kpayinda/PIM_V01/PIM_V01/PIM_V01_DesignRecord.docx

# PIM_V01 PCBA Design Record

Payload Interface Module

Not for flight

Author: Kala Payinda

RAW PCB: PIM_V01_GERBERS

Ordered 13-AUG-26

https://github.com/kpayinda/PIM/commit/edd9c8c313321c0a0980f22faca5c752f7d752eb

Revision Date: 13-AUG-26

## Contents

## Overview

The Payload Interface Module (PIM) is a custom 4-layer PCB that interfaces a 12 V small-satellite bus with customer payloads and onboard processing hardware. The design targets a ~5 krad (Si) total-ionising-dose lifetime with no formal certification requirement, and prioritises low power consumption and fully hand-solderable components.

Core hardware: STM32H7A3VIT6 MCU (LQFP-100), dual FDCAN, USB-C customer interface, TPS62933 point-of-load bucks, TPS55288 programmable payload rail, and a three-tier NOR/FRAM/NAND memory stack. The iCE40 FPGA and its 1V2 core rail are deferred beyond the MVP and are out of scope for this record.

This record captures final design solutions only, with the governing calculation and a short rationale for each. Sections are grouped into flight hardware (populated on the orbital build) and non-flight hardware (ground-support and debug features, DNP for flight).

## 1.0 Flight Design Sections

### 1.1 Input Power

Function: Accept the +12 V satellite bus, protect against reverse polarity and transients, filter switching noise, and split into a housekeeping branch and a fault-isolated payload branch.

Final solution:

- Reverse-polarity protection: high-side P-channel MOSFET Vishay SQJ407EP (blocks reverse current with low conduction loss vs. a series diode).
- Transient protection: SMBJ12A TVS across the input. Chosen over SMBJ16A because its ~19.9 V clamp stays below the downstream eFuse 20 V absolute maximum.
- Input filter: bulk input capacitance plus a C-L-C pi filter on the 12 V rail to stop buck switching noise back-propagating onto the satellite bus.
- Housekeeping branch: feeds the 3V3 and 1V2 bucks directly, bypassing the eFuse, so a payload fault cannot disable the module's own supplies.
- Payload branch: TI TPS259541DSGR eFuse for the payload supply, current limit ≈ 4 A.

eFuse current-limit set: R_ILIM ≈ 511 Ω sets the ~4 A limit per the TPS259541 I_LIM(A) = K_ILIM / R_ILIM relationship.

Rationale: The eFuse sits only on the payload branch — a payload short is current-limited and isolated, while housekeeping remains alive. A dedicated housekeeping eFuse was rejected because a housekeeping fault renders the module useless regardless, and module-level disconnection is handled by the satellite bus.

### 1.2 USB-C Interface

Function: Customer-facing interface for firmware update (DFU) and the digital-twin link. USB Full Speed (12 Mbps), which far exceeds any CubeSat UHF downlink rate — no external ULPI PHY required.

Final solution:

- Connector: GCT 12402143E512A USB-C receptacle.
- CC configuration: 2 × 5.1 kΩ pulldowns on CC1/CC2 (upstream-facing device / sink).
- ESD protection: ST USBLC6-2SC6 on the D+/D− pair.
- Power path: discrete cross-coupled P-FET power selector between USB-VBUS and the bus-derived rail (chosen over the TPS2116 for hand-solderability and part control).
- Local 3V3: AP2112K-3.3 LDO (SOT-23-5) generates 3.3 V from the 5 V USB VBUS for bench operation.
- USB data lines: PA11 (D−) / PA12 (D+) on the STM32H7A3.

DFU bootloader: BOOT0 sampled high at NRST release enters the STM32 ROM bootloader. USB clocking uses the internal HSI48 oscillator with the Clock Recovery System (CRS) locked to USB SOF — no external crystal needed.

Note on pin allocation: because FDCAN1 defaults to PA11/PA12 and would collide with USB, the CAN peripherals are remapped (see §1.5).

### 1.3 Power Regulation (Point-of-Load Bucks)

Function: Generate the +5 V, +3V3 and +1V2 rails from the +12 V bus. A single synchronous buck controller family (TI TPS62933) is used throughout to minimise the BOM and share layout patterns.

Output-voltage setting: Each rail is set by the feedback divider, with R_FBB = 10 kΩ (1 %) on all rails:

V_OUT = 0.8 V × (1 + R_FBT / 10 kΩ)

Rail | R_FBT (1%) | Calculated V_OUT | Purpose
+5V | 52.3 kΩ | 4.98 V | Payload supply
+3V3 | 31.6 kΩ | 3.33 V | MCU VDD, sensors, pull-ups
+1V2 | 4.99 kΩ | 1.20 V | FPGA core (deferred, DNP for MVP)

Inductor selection: Sized for the rail's full 3 A capability (not the present load), targeting ripple ratio K = ΔI_L/I_OUT ≈ 0.3:

L = V_OUT × (V_IN − V_OUT) / (V_IN × f_sw × 0.3 × I_OUT,max)

At V_IN = 12 V, f_sw = 500 kHz, I_OUT,max = 3 A: the 5 V rail needs 6.5 µH and the 3V3 rail 5.3 µH, so a single 6.8 µH part covers both. Selected: Würth WE-LHMI 6.8 µH (shielded). With 6.8 µH the 5 V rail ripple is ≈ 0.86 A (29 %), peak inductor current ≈ 3.4 A; the 3V3 rail ripple is ≈ 0.7 A (23 %).

- Saturation current: I_sat ≥ ~5 A, above the ~3.4 A peak and the IC's high-side current limit, so the core does not saturate before the IC protects.
- RMS / DCR: RMS rating ≥ 3 A, low DCR (~20–50 mΩ) for efficiency.
- Output caps: 2 × 22 µF per rail.
- Switching frequency: RT pin floated for the default 500 kHz (~400–500 kHz keeps harmonics below the UHF band).

### 1.4 Programmable Payload Rail

Function: A firmware-controlled, adjustable supply for the customer payload, able to source above and below 12 V.

Final solution:

- IC: TI TPS55288 buck-boost converter with I²C voltage/current control.
- Hardware voltage ceiling: set by R_top = 115 kΩ, R_bot = 10 kΩ to cap the output regardless of firmware.
- Current sense: 10 mΩ resistor for the internal current loop / telemetry.
- Enable: EN held low at boot; firmware programs the target voltage over I²C before enabling the rail.

Ceiling calculation: With the 1.2 V internal reference: V_OUT(max) = 1.2 V × (1 + 115 kΩ / 10 kΩ) = 15.0 V.

Rationale: The hardware ceiling bounds the worst case even under a firmware fault, and the EN-low-until-configured sequence prevents an undefined voltage from reaching the payload at power-up.

### 1.5 Dual CAN Interface

Function: Redundant command/telemetry link to the host interface adapter via two independent FDCAN buses with firmware failover.

Final solution:

- Transceivers: Microchip MCP2562FDT-E/SN, one per bus.
- Pin allocation: FDCAN1 on PD0/PD1 and FDCAN2 on PB12/PB13 — FDCAN1 moved off its PA11/PA12 default to avoid the USB conflict.
- Termination: split termination at the connector, 2 × 60 Ω with a 4.7 nF cap to GND for common-mode filtering.
- Common-mode filtering: common-mode choke per bus (Würth WE-CNSA 784234101).
- Transient protection: DNP TVS footprints at each connector (fit if the harness environment requires).
- Domain de-coupling: ~1 kΩ series resistors on the TXD lines to mitigate the bench-only power-domain asymmetry between +3V3_MCU and +3V3_HK (identical in flight).

Signal list:

Signal | Direction | Description
FDCAN1_TX | MCU → Transceiver | CAN1 transmit
FDCAN1_RX | Transceiver → MCU | CAN1 receive
FDCAN2_TX | MCU → Transceiver | CAN2 transmit
FDCAN2_RX | Transceiver → MCU | CAN2 receive
CAN1_STBY | MCU → Transceiver | Disable CAN1 driver stage
CAN2_STBY | MCU → Transceiver | Disable CAN2 driver stage

Note: common-mode choke dot polarity is a physical-part property not resolvable from a generic KiCad symbol — use the manufacturer symbol, or fit 0 Ω jumpers and validate orientation on a scope.

### 1.6 Microcontroller

Selected part: STMicroelectronics STM32H7A3VIT6 (Cortex-M7, LQFP-100). LQFP package satisfies the hand-solder constraint.

Final solution:

- Core supply: +3V3 (VDD); internal SMPS/LDO as configured.
- Boot: BOOT0 strapping selects the ROM DFU bootloader (see §1.2).
- Peripherals in use: USB FS (PA11/PA12), FDCAN1/2 (§1.5), SPI to the memory stack (§1.7).
- Firmware: SEU-tolerant design — independent + window watchdogs, memory scrubbing, and CRC-protected critical state in FRAM.

### 1.7 Memory Architecture

Function: Three tiers matched to their reliability needs; all on SPI with independent chip-select lines. SD/eMMC cards were rejected for orbit (hidden controllers, power-cycle corruption risk, uncharacterised single-event-latch-up surface).

Tier | Device | Size | Role
Program | STM32H7A3 internal NOR flash | 2 MB | Firmware and DFU image
Critical state | Infineon FM25V20A-G FRAM | 256 KB | Config / state — dual-copy + CRC32
Bulk telemetry | Winbond W25N01GVSFIG NAND | 1 Gbit | Telemetry logging

Rationale: FRAM holds critical state because it has no wear-out and survives unexpected power loss; it is stored as two CRC-protected copies for SEU integrity. NAND sizing (1 Gbit) is pending confirmation of the actual payload instrument data rate.

### 1.8 Passives Selection

Capacitors: AEC-Q200.

## 2.0 Non-Flight Design Sections

The features below support bench bring-up and debug only. All associated components are do-not-populate (DNP) on flight builds.

### 2.1 Indication LEDs

Status/indication LEDs are a ground-support aid and are DNP on flight builds (parasitic current draw and an additional single-event surface serve no orbital purpose).

TO BE COMPLETED — the design history reviewed for this record contains no finalised indication-LED circuit (rail assignments, series-resistor values, or drive method). Populate this section with the final LED count, the rail each is driven from, and the current-limit resistor per LED before publishing.

### 2.2 Test Points

Debug / SWD access: Bare SWD pads only — no populated connector. Exposed pads: SWDIO, SWCLK, GND, VTREF. Programmed with an ST-LINK or Segger J-Link (internal use only; not exposed to the customer).

General principle: all ground-support-only access (SWD pads and any additional rail/signal test points) is DNP or bare-pad on flight builds, consistent with the DNP-for-flight radiation-mitigation framework.

TO BE COMPLETED — beyond the SWD pads above, the reviewed history does not enumerate dedicated rail/signal test points. Add the final test-point list (net, location/reference) before publishing.

## 3.0 Bring-up Plan

20-SEP-26

RANDOM EDITS.

THE NOTES FROM THE SCHEMATIC:

MCU DESIGN NOTES:

- MCU osc caps: load cap ≈ 2 × (CL − C_stray) = 2 × (18 − ~4.5) ≈ 27Pf

FPGA:

- config: MCU as SPI master, FPGA in slave config mode

- runtime:

POWER UP SEQ:

HK rails immediately on

Initialise H7

Enable PL rails

Check PGOOD

Begin PL operation
