kpayinda/PIM_V01/PIM_V01/PIM_V01_BRINGUP.docx

# PIM_V01 Bring Up Plan

Kala Payinda

27-AUG-26

# 1. Equipment

- Bench PSU (current-limit, 0–30 V/≥1 A)
- DMM ×2 · 4-ch scope + low-C probes
- SWD debugger (ST-LINK/J-Link, 1.27 mm) for J7
- USB-C + STM32CubeProgrammer
- CAN analyser/logic analyser

# 2. Component idle-current reference (from datasheets)

Device | Qty | Rail | Idle / quiescent (typ) | Active / notes
Green LED 150060GS75000 | 9 | various | ≈5 mA each when lit | Vf 3.2 V@20 mA; R's sized so every rail ≈3–5 mA/LED — dominant idle load
TPS62933 buck (U6–U10) | 5 | — | Iq 12 µA (SD 2 µA) | reflected loss only; switching adds little at light load
TPS259541 eFuse (U1) | 1 | 12V_HK | Iq 175 µA (250 max) | +inrush during +12V_PL soft-start
MP28167 VARI (U12) | 1 | 12V_PL | Iq 1 mA (SD 3 µA) | no-load switching a few mA; load = payload
MCP2562FD CAN (U4,U5) | 2 | 5V_HK | 5 mA each recessive | 45 mA each dominant (TX); standby 5 µA
AP2112K LDO (U11) | 1 | 5V_USB | Iq ≈55 µA | USB path only — 0 when on 12 V alone
MT29F1G01 NAND (U13) | 1 | 3V3_MCU | standby ≈0.1 mA | read/prog ≈25 mA (brief)
MB85RS256 FRAM (U14) | 1 | 3V3_MCU | standby ≈µA | read ≈1–2 mA (brief)
USBLC6 ESD (U2) | 1 | — | leakage (nA) | —
STM32H7 MCU (U3) | 1 | 3V3_MCU | run 40–250 mA | clock-dependent — measure; biggest variable

Reflection to 12 V: a lower-rail load costs I₁₂ ≈ P_load /(η·12 V); η≈0.7 at the few-mA LED level, ≈0.85 once a rail carries tens of mA. Buck/eFuse Iq (µA) is negligible.

Part notes: CAN = MCP2562FD (VDD +5V_HK, VIO +3V3_HK, STBY low = always normal). FRAM U14 = MB85RS256. HSE Y1 = 24 MHz. MCU (U3) is not in the supplied BOM — treated as STM32H7 LQFP-100; confirm PN.

# 3. Expected 12 V supply current per stage

Cumulative = board idle at that stage (all indicator LEDs lit, no external payload load). Set the bench limit ~2–3× the cumulative figure.

Stage | Newly-added draw | + @12V | Cumulative @12V (idle) | I-limit | Transients / notes
1A | D14 LED | ~5 mA | ~5 mA | 100 mA | —
1B | eFuse Iq + D15 LED | ~5 mA | ~10 mA | 100 mA | inrush on +12V_PL soft-start
2 | HK bucks + D9,D10 | ~5 mA | ~15 mA | 150 mA | 1V2 rail no LED
3 | 3V3_MCU mux (12 V side) | ~0 | ~15 mA | 150 mA | USB path adds D2 5 mA on USB, not 12 V
4–5 | STM32 run | +15–80 mA | 30–95 mA | 300 mA | flash/DFU; low SYSCLK ≈ low end
6 | NAND+FRAM idle | ~0 | 30–95 mA | 300 mA | NAND read +~10 mA burst
7 | PL rails: D11,D12 + VARI | ~9 mA | 40–105 mA | 400 mA | VARI at V no-load; payload load TBD
8 | 2× CAN recessive | ~5 mA | 45–110 mA | 500 mA | CAN dominant/TX +~40 mA burst
9 | FPGA config lines | ~0 | 45–110 mA | 500 mA | external FPGA powered separately
10 | full board idle | — | 45–110 mA | ≥500 mA | + payload rail load + CAN TX

Range driver = MCU clock: low-speed smoke-test build ≈ low end (~45 mA total); full-speed H7 can push the MCU alone to ~250 mA (~80 mA reflected) → ~110 mA idle. Reading far above these = short or a rail out of regulation, not “just the MCU”.

# 4. Stages

## Stage 0: Bare-board & kit

Side: Both (no parts)

Goal: Confirm PCB + kit before soldering.

Populate

— (inspection only)

Checks / probes

- Every power net open to GND on bare board: +12V_IN, +12V_HK/PL, +5V/+3V3/+1V2_HK, +3V3_MCU, +5V/+3V3/+VARI_PL → OL.
- GND continuity across board (J1 ↔ J10 / mounting holes) < 1 Ω.
- Kit vs BOM: values, polarity marks, thermal-pad parts present; note each part's side from assembly drawing.

Expected @12 V: 0 mA (unpowered).

Gate: Bare board passes visual, all rails open to GND, kit complete.

## Stage 1A: Input protection → +12V_HK

Side: Top

Goal: Reverse-polarity protection + clean 12 V housekeeping.

Populate

J1, Q1 (SQJ407EP), D1 (SMBJ12A), D4 (BZT52C15), R8 100k, C4/C5 47µF, C6 10µF, D14+R79 (LED).

Checks / probes

- Verify J1 polarity first. PSU 12.0 V, limit 100 mA.
- +12V_HK = 11.9–12.0 V; drop across Q1 < 50 mV; D14 lit.
- Reverse test: apply reversed → ~0 mA, +12V_HK ~0 V (Q1 blocks); restore polarity.

Expected @12 V: ~5 mA (D14 only). >20 mA = short (bridge under Q1, or C4/C5 reversed).

Gate: +12V_HK ~12 V, low stable current, D14 lit.

## Stage 1B: eFuse → +12V_PL

Side: Top

Goal: Fused payload bus with soft-start + UVLO.

Populate

U1 (TPS259541), C1 1µF, C2 0.1µF, R2 866k, R3 150k, C3 3.3nF, R5 511R, R7 10k, D3 (PMEG4010), C8 1µF, D15+R80 (LED).

Checks / probes

- +12V_PL ≈ 12 V; scope shows smooth soft-start ramp (no step).
- Raise +12V_IN slowly → PL turns on ~8.1 V (UVLO, R2/R3).
- Don't judge FLT_N here — its pull-up R7 goes to +3V3_HK (not up until Stage 2).

Expected @12 V: ~10 mA cumulative (adds eFuse Iq 0.18 mA + D15 ~5 mA).

Gate: +12V_PL ~12 V, clean soft-start, UVLO ~8.1 V, no latched fault.

## Stage 2: Housekeeping rails 5/3.3/1.2 V

Side: Bottom

Goal: Always-on rails. Fit + test one buck at a time.

Populate

Per rail: U6+L1(+caps,R45,C37,R25/R26,D9/R31)=5V_HK; U7+L2(R27/R28,D10/R32)=3V3_HK; U8+L3(R29/R30)=1V2_HK.

Checks / probes

- +5V_HK 4.85–5.15 V (D9 lit); +3V3_HK 3.20–3.40 V (D10 lit); +1V2_HK 1.16–1.24 V (no LED, probe C48).
- SW node switching clean; ripple <~1% pk-pk; EN pin ≈ VIN (auto-on via 470k).
- Now +3V3_HK is up → re-check eFuse FLT_N = high (no fault).
- ICs/inductors warm not hot after ~2 min.

Expected @12 V: ~15 mA cumulative (D9,D10 reflected ~5 mA; buck Iq negligible).

Gate: All three HK rails in tol, ripple/thermals OK, eFuse fault healthy.

## Stage 3: USB path & +3V3_MCU mux

Side: Top

Goal: MCU rail from USB-only, bus-only, and both, no contention.

Populate

J4, R1/R4 5.1k (CC), C7/CB2, U2 (USBLC6), C78, U11 (AP2112K), C79, D2+R6, Q2/Q3 (FDN304P), Q4 (DMG2302), R10/R11/R12, R68/R69, C9 10µF.

Checks / probes

- USB-only (bus off): +5V_USB ~5 V (D2 lit), +3V3_USB ~3.3 V, +3V3_MCU ~3.3 V; +12V_HK/+3V3_HK ~0 (no back-feed).
- Bus-only (USB out): +3V3_MCU ~3.3 V via HK path; +5V_USB ~0.
- Both: +3V3_MCU stable, no elevated contention current; CC pull-downs = 5.1k.

Expected @12 V: On 12 V: ~15 mA (mux adds ~0, no MCU yet). On USB: ~5 mA (D2) + LDO 55 µA.

Gate: +3V3_MCU = 3.3 V cleanly from either/both sources, no back-feed.

## Stage 4: MCU core & debug

Side: Top

Goal: STM32 alive; SWD + USB-DFU proven. Power from USB only.

Populate

U3, C89–C95 (decoupling), C99/C98 (VDDA/VREF), C96/C97 2.2µF (VCAP), Y1 24MHz + C64/C100 27pF, SW1+C63, J8+R13 10k (BOOT0), J7 (SWD).

Caution: First light from USB only. If using the bench 12 V instead, limit to ~150 mA (MCU + HK is well under that).

Checks / probes

- +3V3_MCU at MCU (C95) 3.2–3.4 V; VCAP (C96) ~1.2 V (core LDO alive); VDDA/VREF 3.3 V.
- nRST idle ~3.3 V, SW1 → 0 V; BOOT0 low with J8 open.
- SWD reads correct STM32H7 IDCODE; HSE (24 MHz) oscillates after FW enable (check via MCO).
- J8 jumpered (BOOT0 high) + USB → enumerates as ‘STM32 BOOTLOADER’ (DFU).

Expected @12 V: USB-powered here. If run from 12 V: adds ~15–80 mA reflected (SYSCLK-dependent) → ~30–95 mA.

Gate: SWD reads correct IDCODE, VCAP ~1.2 V, DFU enumerates.

## Stage 5: FW smoke test & GPIO

Side: — (opt: D5/D6+R81/R82)

Goal: Clock tree, GPIO, enables, source-sense.

Populate

Optional: D5,D6 + R81/R82 100R (TEST LEDs on PB8/PB9).

Checks / probes

- TEST LEDs blink; MCO shows expected SYSCLK; enable GPIOs PE0/PE1/PE2 toggle (no rail effect yet).
- R68/R69 sense reads bus-vs-USB source correctly.

Expected @12 V: As Stage 4; +~5 mA reflected per TEST LED when lit.

Gate: FW runs, clocks correct, enables + source-sense behave.

## Stage 6: NAND + FRAM

Side: Top

Goal: Prove OCTOSPI NAND + SPI4 FRAM.

Populate

U13 (MT29F1G01) + C80/C81, R59 10k (nCS), R60/R61 10k (WP#/HOLD#); U14 (MB85RS256) + decoupling.

Checks / probes

- NAND read-ID = Micron MT29F1G01 (0x2C…); erase/program/read a block, verify.
- FRAM read-ID = expected signature; write pattern, read back (no erase).
- nCS idle high; SCK/IO edges clean.

Expected @12 V: Idle unchanged (standby ~0.1 mA NAND, µA FRAM). Read bursts +~10 mA reflected.

Gate: Both memories return correct IDs and pass write/verify (mark U14 N/A if not stuffed).

## Stage 7: Payload rails 5/3.3/VARI

## CHARACTERISATION W LOAD (SAG)

Side: Bottom

Goal: MCU-switched PL rails, payload isolated.

Populate

One at a time: U9+L4(R37/R38,D11/R33)=5V_PL; U10+L5(R39/R40,D12/R34)=3V3_PL; U12+L6(R53/R54/R56,caps)=VARI. Preconditions: +12V_PL up, MCU running, enables LOW, J11/J12 OPEN.

Caution: VARI reaches 16.8 V but the VARI output caps on this build are rated only 10 V (schematic note). Do NOT command >10 V until the fitted caps are confirmed rated for it, they will be destroyed. Keep the dev setpoint under the cap rating.

Checks / probes

- +5V_EN low → +5V_PL 0 V; drive PE1 high → 4.85–5.15 V (D11). PE0 → +3V3_PL 3.2–3.4 V (D12).
- VARI: I²C scan ACKs 0x60; enable + program a LOW setpoint first, verify, then target.
- MP28167 seq (per note): VREF_L(0x00)=0x05, VREF_H(0x01)=0xEF, GO(0x02)=0x01→16.8 V; IOUT_LIM(0x03)=0x32→2.5 A; CTL1(0x04)=0xB0. Verify vs datasheet map.

Expected @12 V: +~9 mA cumulative (D11+D12 ~5 mA, VARI no-load ~4 mA) → 40–105 mA. VARI load = payload.

Gate: 5V_PL/3V3_PL enable on command in tol; VARI ACKs + holds a safe setpoint. Leave J11/J12 open.

## Stage 8: CAN & payload comms

Side: Top

Goal: Both CAN channels + payload SPI2/USART3/I²C2.

Populate

U4,U5 (MCP2562FD), FL1/FL2 (CMC), R18–R21 60.4R term, R43/R44 1k, D7/D8 (ESD), J5/J6.

Checks / probes

- CAN VDD=+5V_HK, VIO=+3V3_HK; recessive idle CANH≈CANL≈2.5 V; dominant diff ~2 V (TP5–TP8).
- CAN0 loopback: TP1(TX)/TP2(RX) toggle; then external frame on J5 (60.4R term) → TX/RX + ACK. Repeat CAN1 (J6, TP3/4).
- Payload: SPI2 SCK/MOSI/nCS clocked data; USART3 TX baud correct; I²C2 scan/ACK.

Expected @12 V: +~5 mA idle (2× 5 mA recessive reflected). Dominant/TX bursts +~40 mA — expect current jumps during traffic.

Gate: Both CAN channels TX/RX an ACK'd frame; payload buses signal correctly.

## Stage 9: FPGA config (SPI1)

Side: Top

Goal: MCU drives iCE40-style config on J9.

Populate

R62–R65 33R (series), R66/R67 10k (pull-ups), J9.

Checks / probes

- Idle: nCRESET/nSS/CDONE/FPGA_INT high (pull-ups); 33R series present.
- LA on J9: valid reset→clock→bitstream sequence; with FPGA attached, CDONE asserts high on success.

Expected @12 V: ~0 added on-board (pull-ups µA). External FPGA powered separately — not in this budget.

Gate: Clean, correctly-sequenced config waveform; CDONE asserts (if FPGA present).

## Stage 10: Full integration & sequence

Side: Both

Goal: Whole board in intended order, end-to-end.

Populate

Remaining: R83–R86/C105–C108 (chassis RC) + any final parts.

Checks / probes

- Sequence (scope multi-ch): +12V_IN → HK rails auto → +12V_PL (eFuse) → MCU enables +3V3_PL/+5V_PL/+VARI in order → program VARI → payload op.
- eFuse fault path: force overcurrent → PL_FLT to MCU trips. Brown-out: ramp 12 V down → graceful UVLO.
- Fit J11/J12 only after payload load verified. Thermal soak 15 min.

Expected @12 V: 45–110 mA idle (per §3) + payload rail load + CAN-TX bursts. Log full-load draw at +12V_IN.

Gate: Board follows designed sequence, subsystems work under integrated power, faults behave, thermals stable.

# 5. Sign-off Template

Stage | Description | Meas. 12 V (mA) | Date | P/F
0 | Bare board & kit
1A | Input prot → 12V_HK
1B | eFuse → 12V_PL
2 | HK rails
3 | USB & 3V3_MCU mux
4 | MCU core & debug
5 | FW smoke test
6 | NAND + FRAM
7 | Payload rails
8 | CAN & comms
9 | FPGA config
10 | Integration & sequence

# 6. Population Instances

## 6.1 Population Instance #1

29-AUG-26. Kala Payinda. RL soldering labs

Stage | Date | Power | Notes
0 | 29-AUG | N/A
1A | 29-AUG | 12V,4mA | D4 absent (unpop), not blocking.
1B | 29-AUG | XXX | U1 absent (unpop), BLOCKING. Can’t test _PL.
2 | 29-AUG | 12V,10mA | C38 -> 33nF instead. 52.3kR absent (replaced w 2x||100kR). 4.99kR absent (replaced w 5.1kR). - 3V3 rail: 3.354V - 1V2 rail: 1.263V - 5V rail: 4.856V
3 | 29-AUG | | U2 absent (unpop). Q2 Q3 absent.

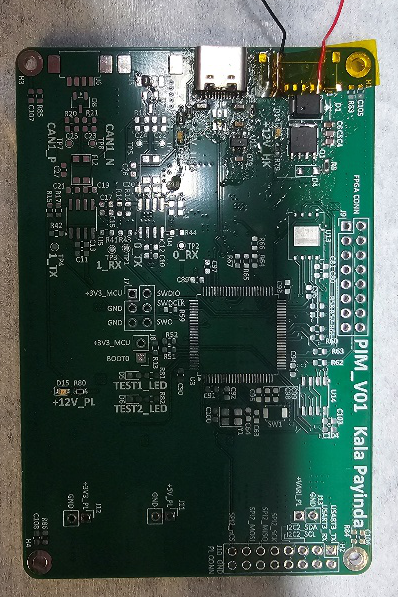
[picture p1: figure]
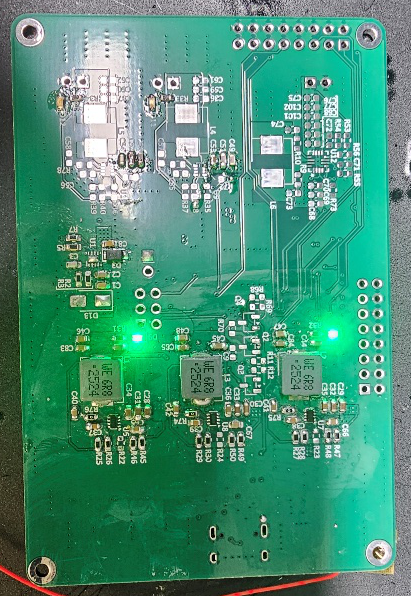
[picture p2: figure]

08-SEP-26. Kala Payinda. Uni

New plan from components not being present for the next week.

1. Test USB-C. Ben provided a USB adaptor that allows a PSU to control power into a USB cable. I will input 5V with hard current limit, and connect it to my PCB now. The LED should come on and the 3V3 LDO should regulate correctly. If this works, then the MCU can be flashed.
2. Populate MCU. Test its ability to be flashed.

Results:

- PSU 5V/2mA: C78: 4.993V, C79: 3.304V
- PSU 5V5/3mA: C78: 5.495, C79: 3.304V
- PSU 4V5/1mA: C78: 4.495V, C79: 3.304V

09-SEP-26. KP. RL

Populated all MCU region.

Results:

- Powered w PSU into power-only USB-C 5V//16mA draw.
- C96 (1V2): 1.009V
- 3V3_MCU: 3.301V
- C98 (VREF+): 3.305V

Obv usb device not showing up on laptop bc dfu cant start w external xtal

10-SEP-26. KP. UNI

Swapping short to have 3v3_mcu just from 12v input. Then try flashing w SWD… still didn’t work.

11-SEP-26. KP. UNI

Only progress was updating stmcubeprog and then its now able to see a target voltage of 3v3. Other note, the ‘missing’ components arrived so now I have all components I need for a fully populated board theoretically.

Usbc: still not working. Tested the D+ and D- continuity, all is fine. My manual shorts are behaving exactly as they should. Tried pulling PA9 (68) high to 5v to see if that allowed it to enter a mode, that didn’t help.

SWD: Tried fixed, added 10k between SWDIO and 3v3, tried putting it in boot0 and not, tried playing w nrst as I pressed connect.

I scoped the IO and CLK pins while they were connected to the pcb, and saw perfect signals as I would expect. The clk was a normal looking square wave that was just one section of it. The IO was a normal 3v3 then a few sections of multiple pulses dragging the signal to 0.

Next step: something is wrong. I am going to make a MVP just to see if my boards mcu is ever able to enter boot mode or be flashed in any way.

MVP:

Populate:

- U3 and its decoupling: C89–C95 (the VDD 100 nF's + bulk), plus C99/C98 on VDDA/VREF+.
- Both VCAP caps — C96 and C97 (2.2 µF). Non-negotiable; the internal core LDO won't be stable without them and that's likely your current problem.
- nRST: C63, and SW1 or just a pull-up — nRST must idle at 3.3 V.
- BOOT0: R13 (pull-down) so it sits low.
- J7 (SWD) — SWDIO, SWCLK, GND, 3V3.
- A clean 3.3 V into VDD/VDDA and solid GND. You can feed 3.3 V straight from a bench supply onto the VDD rail — you do not need the USB-C path, the LDO, the mux, or any of the power tree. SWD flashing needs nothing but VDD, GND, VCAP caps, nRST high, BOOT0 low, and the four SWD wires.

15-SEP-26. KP. UNI

Louis checked w known good mcu and the STLink we bought from digikey does not work.

IMO flashing through DFU should work. My RL pcb I designed works perfectly ONLY through DFU. I am going to add DFU capability to the MVP board.

USB-DFU MVP populate:

- ~~U3~~ ~~+ all decoupling: C89–C94, C95, and C99/C98 on VDDA/VREF+.~~
- ~~Both VCAP caps~~ ~~C96/C97 (2.2 µF).~~
- ~~nRST~~~~: C63~~ ~~plus a 10 kΩ pull-up to 3V3~~ ~~— you just proved this was missing and pulling the chip into reset. Even for DFU, if nRST is held low the bootloader never runs. This is mandatory now.~~
- ~~BOOT0~~~~: your J8 jumper tied high (BOOT0 → 3V3). Confirm 3.3 V at pin 94.~~
- VBAT (6) → 3V3, VDDA (21) → 3V3, VSSA → GND, all VSS → GND, all VDD → 3V3.
- The USB-C data path: the receptacle, and the D+/D− lines from it to PA12 (pin 71) / PA11 (pin 70). Since you don't have U2, bridge its footprint (1↔6, 3↔4) exactly as before — nothing touching pins 2 (GND) or 5 (VBUS).
- CC pulldowns: R1/R4 (5.1 kΩ) on the USB-C CC lines — without these a Type-C host won't even apply VBUS.
- PA9 (pin 68) wired to VBUS (5 V) — the fix for the no-connect. This is the part your board omits and the reason DFU never enumerated. Put it in from the start.
- Power: you can run the whole thing off the USB-C 5 V through your AP2112 path, or feed 3.3 V from a bench supply onto VDD and just use the USB cable for data + VBUS-sense. Either works; bench 3.3 V removes the LDO/mux as variables.

15

Populated another pcb just with ONLY the usb-c connections. But still nort working. Im going to cut open a usb-c cable and probe all to see if my connection is even good. Then probe EVERYTING, between all possible pins.

17-SEP-26. KP. UNI

MVP MCU resoldered as SWD actually didn’t have continuity. So that’s fixed now.

Testing on MVP

19-SEP-26. KP. RL

Mcu works so continuing checklist now. Have all components

Soldered the whole board. Power selector not selecting usb-c correctly… will debug now.

Power selector circuit is wrong. The PMOSs polarity is the wrong way. I attempted to solder them on an angle so 2 legs were direct at the pads then white-wired the 3rd leg to the correct pad, but this didn’t work (got 0V @ +3V3_MCU, and the +12V LED was dimly on, and I think the +1V2 LED was on. So that clearly wasn’t correct. I think that I might have accidentally shorted something wrong when I added the white wires, not too sure.

For now I just removed the 2x PMOS, and shorted the +3V3_USB to +3V3_MCU, and I managed to flash the basic Test LED firmware through DFU successfully.

The eFuse is also not working rn.

Debug steps:

- Ensure polarity correct
- Measure EN_UVLO (pin 2) to GND. Expect 1V2.
- Confirm IN actually reaches the chip. Probe pins 3 and 4 directly on the IC lead.
- Read FLT_N (pin 6). Should be 3V3 (no fault).

Its working. All good. I think the issue was that my diode was the wrong way lol. Fixed now.

Got claude to write me a basic .elf to enable the 3v3 and 5v PL. this worked, both rails were up!

20-SEP-26. KP. UNI

Tried turning vari on, didn’t work. I added more solder to the pads with an iron (very hard to access, would have been easier with a heat gun), then also changed out the 22uF (which are only rated to 10V) with 10uF (rated to 25V). This allows safe testing of above 10V. We tested up to 9V (the prev SW limit), and it worked perfectly, and was precise.
