kpayinda/PIM_V01/PIM_V01/Outputs/pim_sch.pdf

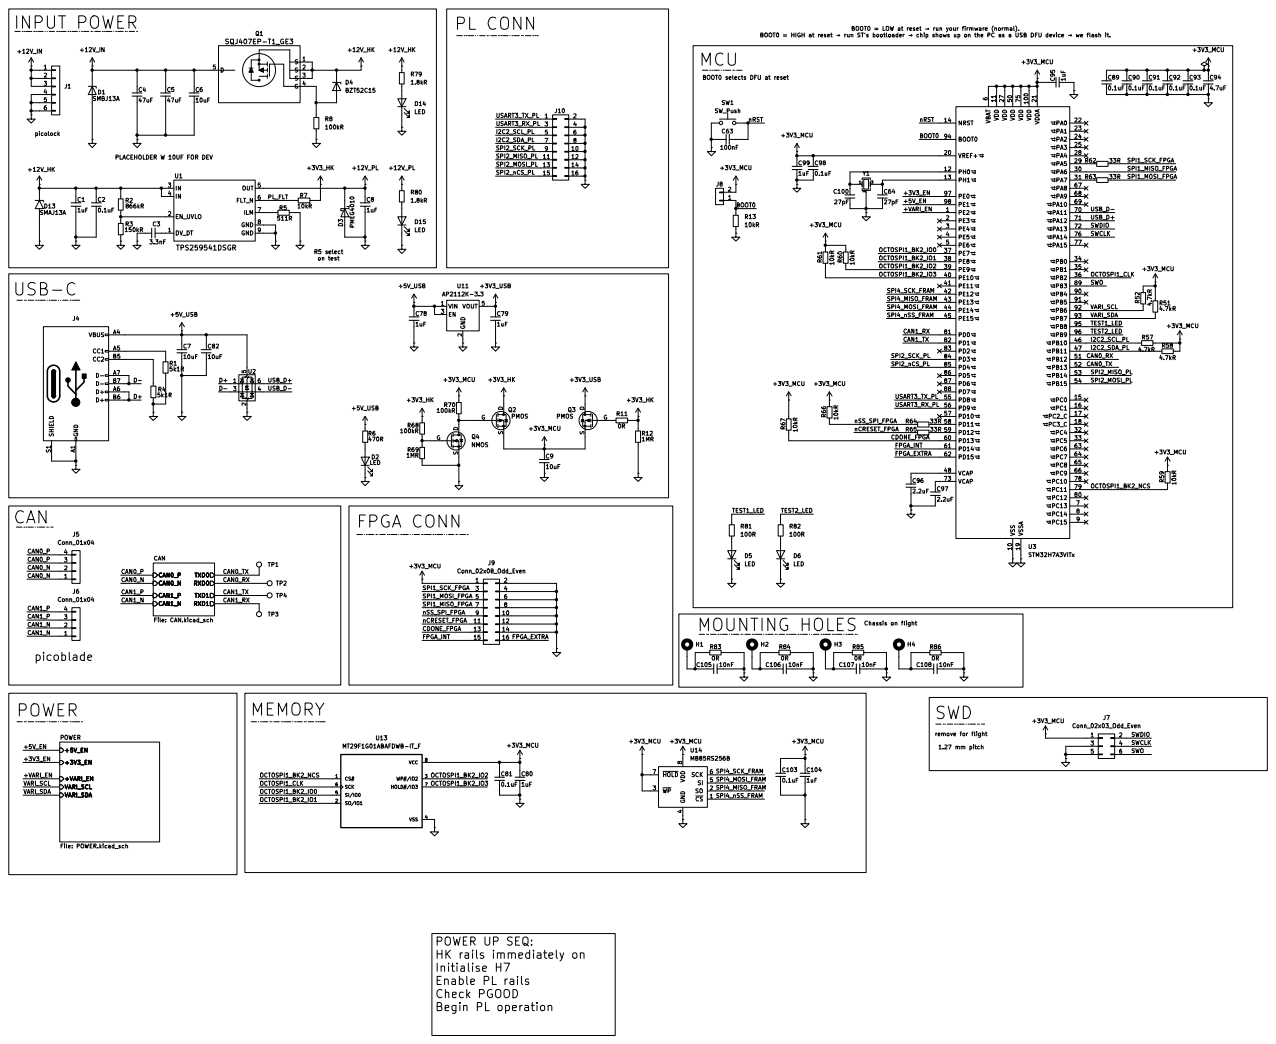
[picture p3: page 1]

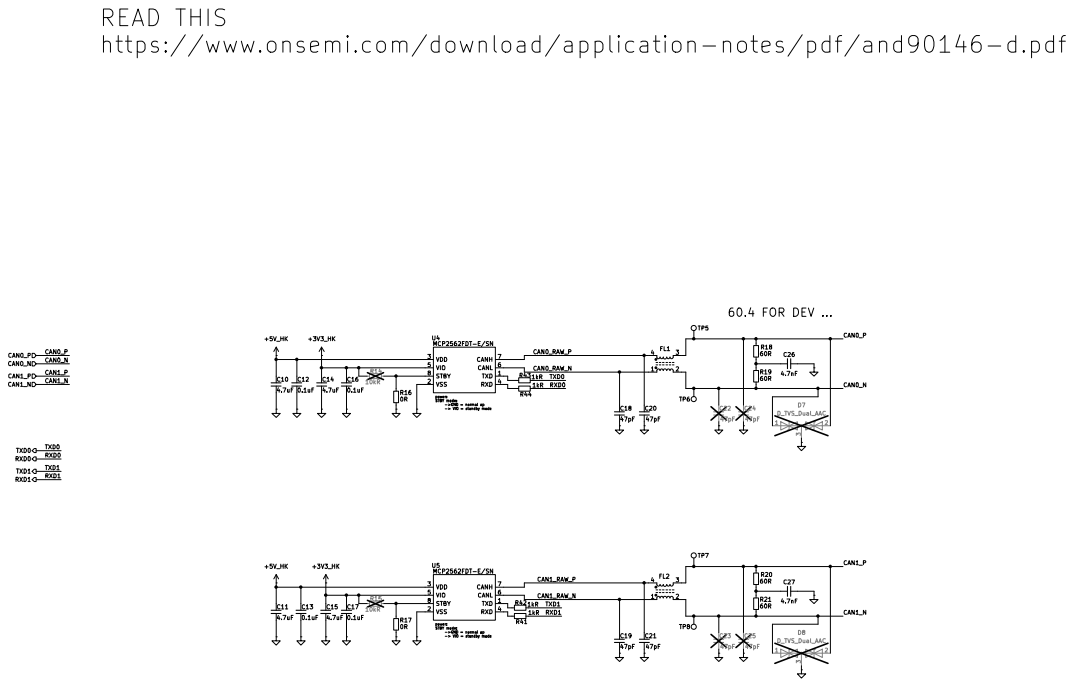
[picture p4: page 2]

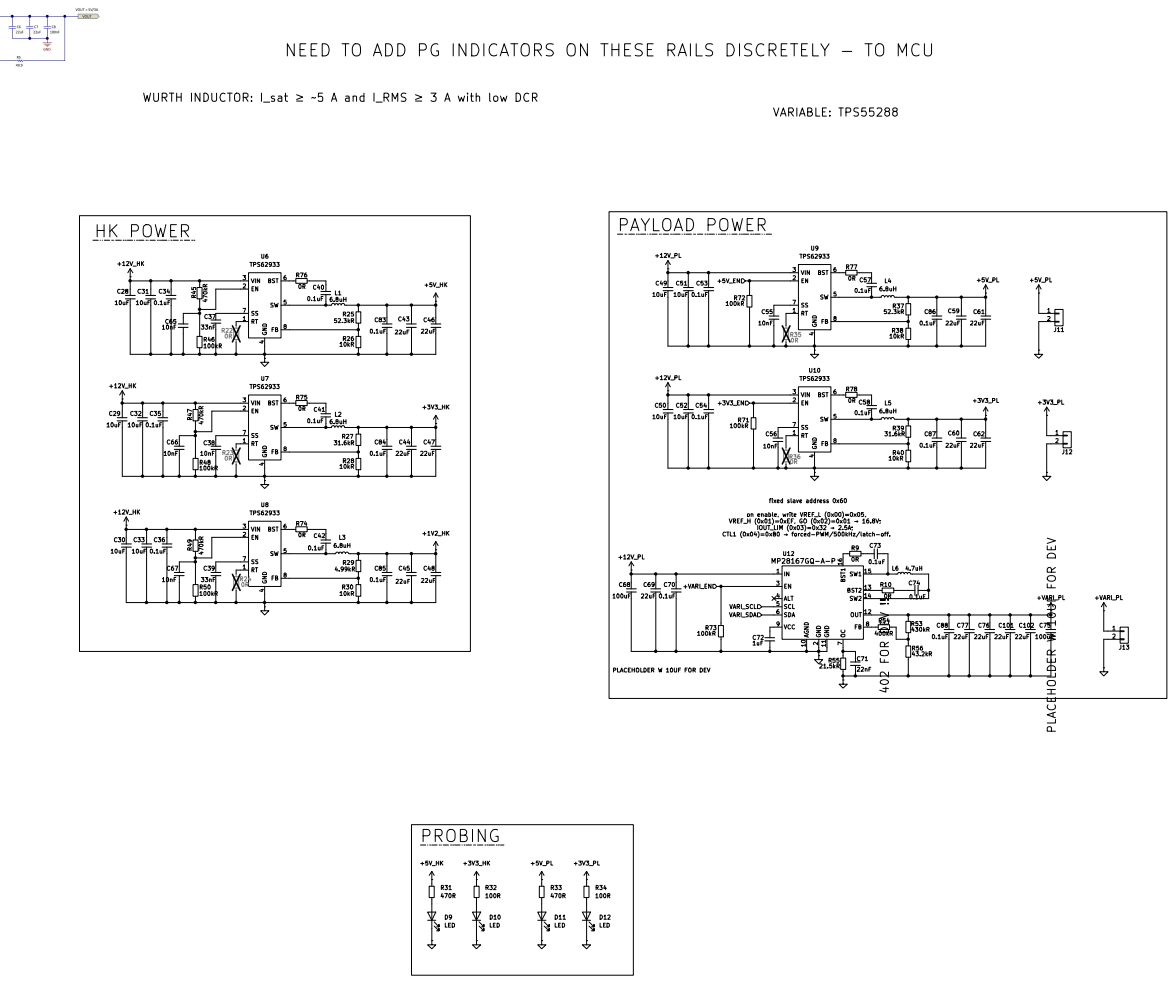
[picture p5: page 3]
