kpayinda/PIM_V01/PIM_V01/PIM_V01.kicad_pcb

## KiCad design PIM_V01/PIM_V01.kicad_pcb (2026-09-21)

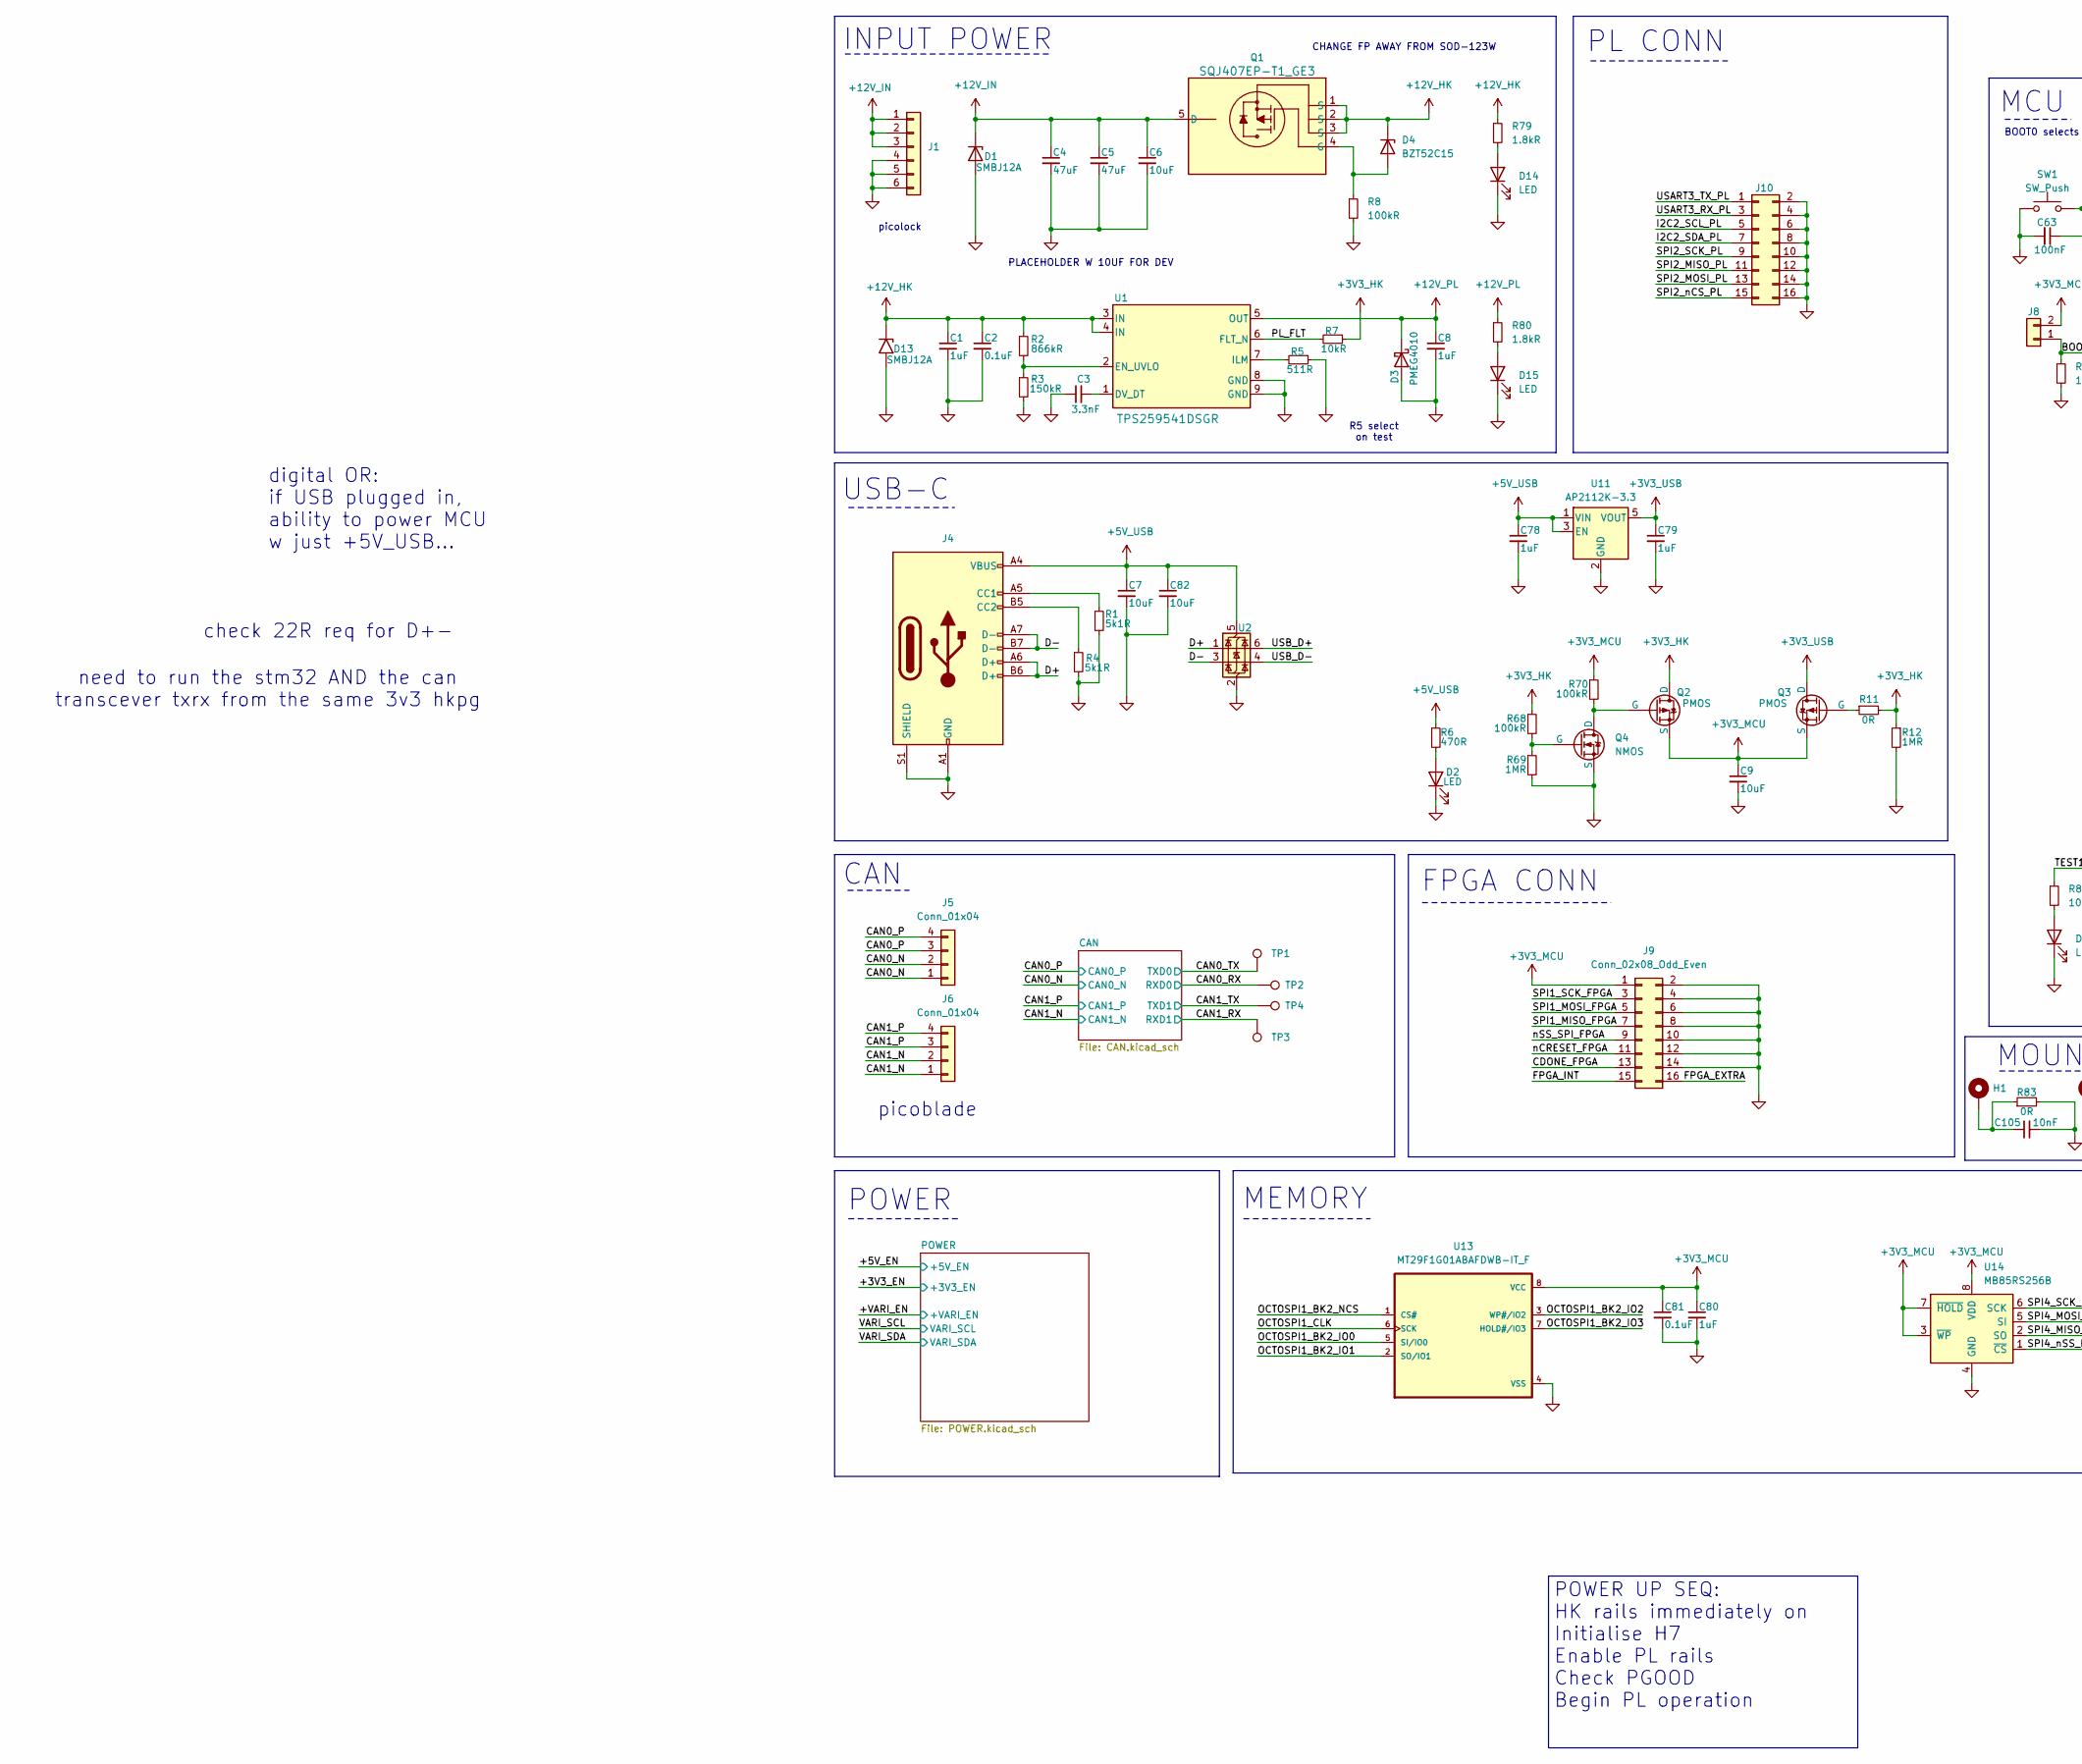
[picture p6: schematic PIM_V01.kicad_sch, PCI-104 Template, part in row 1, column 1]

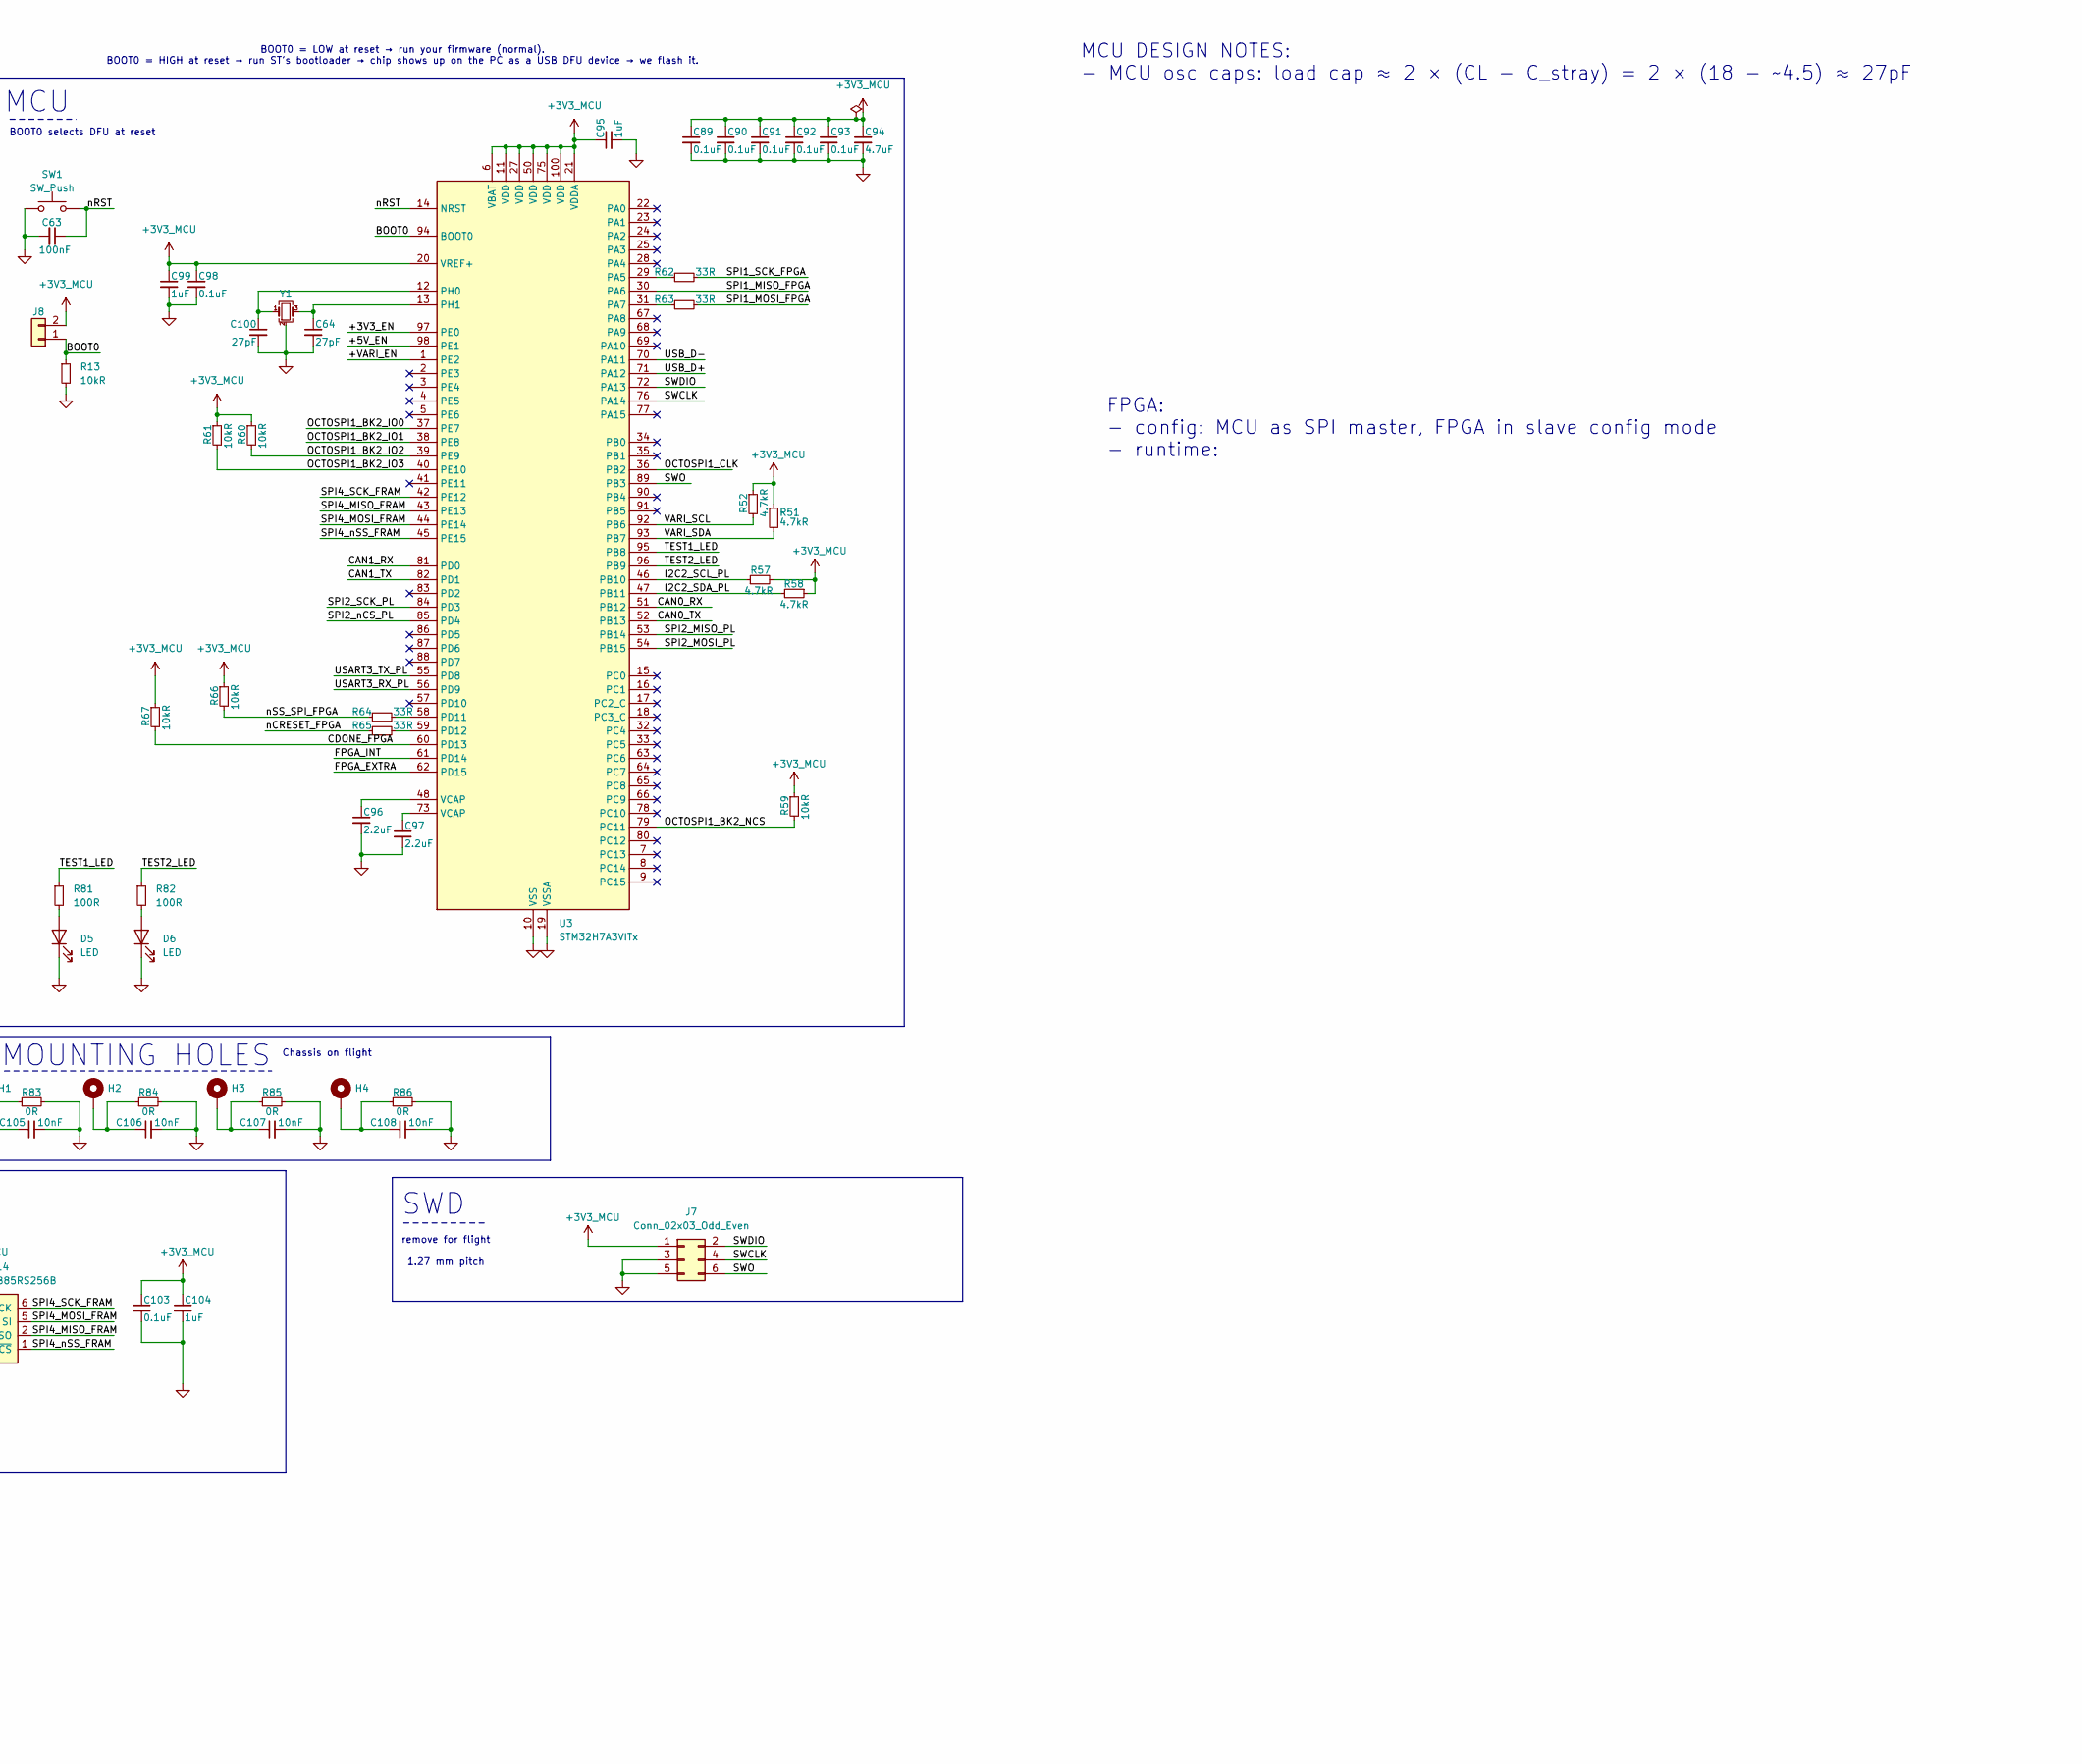
[picture p7: schematic PIM_V01.kicad_sch, PCI-104 Template, part in row 1, column 2]

Parts:
C1, C8, C78, C79, C80, C95, C99, C104: 1uF; C_0603_1608Metric; MPN GCM188R71E105KA64J
C2, C81, C89, C90, C91, C92, C93, C98, C103: 0.1uF; C_0603_1608Metric; MPN GCM188R71H104KA57D
C3: 3.3nF; C_0603_1608Metric; MPN GCM1885C1H332JA16D
C4, C5: 47uF; C_0603_1608Metric; Rating 50V, MLCC; MPN GRT188R61E106ME13D
C6, C7, C9, C82: 10uF; C_0603_1608Metric; MPN GRT188R61E106ME13D
C63: 100nF; C_0603_1608Metric; MPN GCM188R71H104KA57D
C64, C100: 27pF; C_0603_1608Metric; MPN GCM1885C1H270JA16D
C94: 4.7uF; C_0603_1608Metric; MPN MSAST168BB5475MTNA01
C96, C97: 2.2uF; C_0603_1608Metric; MPN GRT188R61E225ME13D
C105, C106, C107, C108: 10nF; C_0603_1608Metric; MPN GCM188R71H103KA37J
D1: SMBJ12A; SMBJ16A; MPN SMBJ12A
D2, D5, D6, D14, D15: LED; LED_0603_1608Metric; MPN 150060GS75000
D3: PMEG4010; Nexperia_CFP3_SOD-123W; MPN PMEG4010ER,115
D4: BZT52C15; Nexperia_CFP3_SOD-123W; MPN BZT52C15
D13: SMBJ12A; D_SMA; MPN SMBJ12A
H1, H2, H3, H4: MountingHole_Pad; MountingHole_2.2mm_M2_Pad
J1: Conn_01x06; Molex_Pico-Lock_504050-0691_1x06-1MP_P1.50mm_Horizontal; MPN 5040500691
J4: USB_C_Receptacle_USB2.0_14P; USB_C_Receptacle_GCT_USB4105-xx-A_16P_TopMnt_Horizontal; MPN USB4105-GF-A
J5, J6: Conn_01x04; Molex_PicoBlade_53261-0471_1x04-1MP_P1.25mm_Horizontal; MPN 0532610471
J7: Conn_02x03_Odd_Even; PinHeader_2x03_P2.54mm_Vertical; MPN 61304021121
J8: Conn_01x02; PinHeader_1x02_P2.54mm_Vertical; MPN 61304011121
J9, J10: Conn_02x08_Odd_Even; PinHeader_2x08_P2.54mm_Vertical; MPN 61304021121
Q1: SQJ407EP-T1_GE3; PowerPAK-SO-8L_Option-2_VIS; MPN SQJ407EP-T1_GE3
Q2, Q3: PMOS; SOT-23-3; MPN DMG2305UX-7
Q4: NMOS; SOT-23-3; MPN DMG2302UK-7
R1, R4: 5k1R; R_0603_1608Metric; MPN ERJ-3EKF5101V
R2: 866kR; R_0603_1608Metric; MPN ERJ-3EKF8663V
R3: 150kR; R_0603_1608Metric; MPN ERJ-3EKF1503V
R5: 511R; R_0603_1608Metric; MPN ERJ-3EKF5110V
R6: 470R; R_0603_1608Metric; MPN ERJ-3EKF4700V
R7, R13, R59, R60, R61, R66, R67: 10kR; R_0603_1608Metric; MPN ERJ-3EKF1002V
R8, R68, R70: 100kR; R_0603_1608Metric; MPN ERJ-3EKF1003V
R11, R83, R84, R85, R86: 0R; R_0603_1608Metric; MPN ERJ-3GEY0R00V
R12, R69: 1MR; R_0603_1608Metric; MPN ERJ-3EKF1004V
R51, R52, R57, R58: 4.7kR; R_0603_1608Metric; MPN ERJ-3EKF4701V
R62, R63, R64, R65: 33R; R_0603_1608Metric; MPN ERJ-3EKF33R0V
R79, R80: 1.8kR; R_0603_1608Metric; MPN ERJ-3EKF1801V
R81, R82: 100R; R_0603_1608Metric; MPN ERJ-3EKF1000V
SW1: SW_Push; SW_SPST_B3U-1000P; MPN B3U-1000P
TP1, TP2, TP3, TP4: TestPoint; TestPoint_Pad_D1.0mm
U1: TPS259541DSGR; DSG0008A; MPN TPS259541DSGR
U2: USBLC6-2SC6; SOT-23-6; MPN USBLC6-2SC6
U3: STM32H7A3VITx; LQFP-100_14x14mm_P0.5mm; MPN STM32H7A3VIT6
U11: AP2112K-3.3; SOT-23-5; MPN AP2112K-3.3TRG1
U13: MT29F1G01ABAFDWB-IT_F; SON127P600X800X65-8N; PARTREV LTR
U14: MB85RS256B; JEITA_SOIC-8_3.9x4.9mm_P1.27mm; MPN MB85RS256BPNF-G-AMERE2
Y1: Crystal_GND24_Small; Crystal_SMD_Abracon_ABM8G-4Pin_3.2x2.5mm; MPN ABM8G-24.000MHZ-18-D2Y-T3

Connections:
+3V3_HK: Q2.1 (D), R7.1, R11.2, R12.1, R68.1; also elsewhere on the board
+3V3_MCU: C9.1, C80.1, C81.1, C89.1, C90.1, C91.1, C92.1, C93.1, C94.1, C95.1, C98.1, C99.1, C103.1, C104.1, J7.1, J8.2, J9.1, Q2.3 (S), Q3.3 (S), R51.1, R52.1, R57.2, R58.1, R59.1, R60.1, R61.1, R66.1, R67.1, R70.1, U3.6 (VBAT), U3.11 (VDD), U3.20 (VREF+), U3.21 (VDDA), U3.27 (VDD), U3.50 (VDD), U3.75 (VDD), U3.100 (VDD), U13.8 (VCC), U14.3 (~WP), U14.7 (~HOLD), U14.8 (VDD)
+3V3_USB: C79.1, Q3.1 (D), U11.5 (VOUT)
+5V_USB: C7.1, C78.1, C82.1, J4.A4 (VBUS), J4.A9 (VBUS), J4.B4 (VBUS), J4.B9 (VBUS), R6.1, U2.5 (VBUS), U11.1 (VIN), U11.3 (EN)
+12V_HK: C1.1, C2.1, D4.1 (K), D13.1 (A1), Q1.1 (S), Q1.2 (S), Q1.3 (S), R2.1, R79.1, U1.3 (IN), U1.4 (IN); also elsewhere on the board
+12V_IN: C4.1, C5.1, C6.1, D1.1 (K), J1.1, J1.2, J1.3, Q1.5 (D)
+12V_PL: C8.1, D3.1 (K), R80.1, U1.5 (OUT); also elsewhere on the board
/+3V3_EN: U3.97 (PE0); also elsewhere on the board
/+5V_EN: U3.98 (PE1); also elsewhere on the board
/+VARI_EN: U3.1 (PE2); also elsewhere on the board
/BOOT0: J8.1, R13.1, U3.94 (BOOT0)
/CAN0_N: J5.1, J5.2; also elsewhere on the board
/CAN0_P: J5.3, J5.4; also elsewhere on the board
/CAN0_RX: TP2.1, U3.51 (PB12); also elsewhere on the board
/CAN0_TX: TP1.1, U3.52 (PB13); also elsewhere on the board
/CAN1_N: J6.1, J6.2; also elsewhere on the board
/CAN1_P: J6.3, J6.4; also elsewhere on the board
/CAN1_RX: TP3.1, U3.81 (PD0); also elsewhere on the board
/CAN1_TX: TP4.1, U3.82 (PD1); also elsewhere on the board
/CDONE_FPGA: J9.13, R67.2, U3.60 (PD13)
/D+: J4.A6 (D+), J4.B6 (D+), U2.1 (I/O1)
/D-: J4.A7 (D-), J4.B7 (D-), U2.3 (I/O2)
/FPGA_EXTRA: J9.16, U3.62 (PD15)
/FPGA_INT: J9.15, U3.61 (PD14)
/I2C2_SCL_PL: J10.5, R57.1, U3.46 (PB10)
/I2C2_SDA_PL: J10.7, R58.2, U3.47 (PB11)
/OCTOSPI1_BK2_IO0: U3.37 (PE7), U13.5 (SI/IO0)
/OCTOSPI1_BK2_IO1: U3.38 (PE8), U13.2 (SO/IO1)
/OCTOSPI1_BK2_IO2: R60.2, U3.39 (PE9), U13.3 (WP#/IO2)
/OCTOSPI1_BK2_IO3: R61.2, U3.40 (PE10), U13.7 (HOLD#/IO3)
/OCTOSPI1_BK2_NCS: R59.2, U3.79 (PC11), U13.1 (CS#)
/OCTOSPI1_CLK: U3.36 (PB2), U13.6 (SCK)
/PL_FLT: R7.2, U1.6 (FLT_N)
/SPI1_MISO_FPGA: J9.7, U3.30 (PA6)
/SPI1_MOSI_FPGA: J9.5, R63.2
/SPI1_SCK_FPGA: J9.3, R62.2
/SPI2_MISO_PL: J10.11, U3.53 (PB14)
/SPI2_MOSI_PL: J10.13, U3.54 (PB15)
/SPI2_SCK_PL: J10.9, U3.84 (PD3)
/SPI2_nCS_PL: J10.15, U3.85 (PD4)
/SPI4_MISO_FRAM: U3.43 (PE13), U14.2 (SO)
/SPI4_MOSI_FRAM: U3.44 (PE14), U14.5 (SI)
/SPI4_SCK_FRAM: U3.42 (PE12), U14.6 (SCK)
/SPI4_nSS_FRAM: U3.45 (PE15), U14.1 (~CS)
/SWCLK: J7.4, U3.76 (PA14)
/SWDIO: J7.2, U3.72 (PA13)
/SWO: J7.6, U3.89 (PB3)
/TEST1_LED: R81.1, U3.95 (PB8)
/TEST2_LED: R82.1, U3.96 (PB9)
/USART3_RX_PL: J10.3, U3.56 (PD9)
/USART3_TX_PL: J10.1, U3.55 (PD8)
/USB_D+: U2.6 (I/O1), U3.71 (PA12)
/USB_D-: U2.4 (I/O2), U3.70 (PA11)
/VARI_SCL: R52.2, U3.92 (PB6); also elsewhere on the board
/VARI_SDA: R51.2, U3.93 (PB7); also elsewhere on the board
/nCRESET_FPGA: J9.11, R65.1
/nRST: C63.1, SW1.2, U3.14 (NRST)
/nSS_SPI_FPGA: J9.9, R64.1, R66.2
GND: C1.2, C2.2, C3.1, C4.2, C5.2, C6.2, C7.2, C8.2, C9.2, C63.2, C64.2, C78.2, C79.2, C80.2, C81.2, C82.2, C89.2, C90.2, C91.2, C92.2, C93.2, C94.2, C95.2, C96.2, C97.2, C98.2, C99.2, C100.2, C103.2, C104.2, C105.2, C106.2, C107.2, C108.2, D1.2 (A), D2.1 (K), D3.2 (A), D5.1 (K), D6.1 (K), D13.2 (A2), D14.1 (K), D15.1 (K), J1.4, J1.5, J1.6, J4.A1 (GND), J4.A12 (GND), J4.B1 (GND), J4.B12 (GND), J4.S1 (SHIELD), J7.3, J7.5, J9.2, J9.4, J9.6, J9.8, J9.10, J9.12, J9.14, J10.2, J10.4, J10.6, J10.8, J10.10, J10.12, J10.14, J10.16, Q4.3 (S), R1.2, R3.2, R4.2, R5.1, R8.2, R12.2, R13.2, R69.2, R83.2, R84.2, R85.2, R86.2, SW1.1, U1.8 (GND), U1.9 (GND), U2.2 (GND), U3.10 (VSS), U3.19 (VSSA), U3.26 (VSS), U3.49 (VSS), U3.74 (VSS), U3.99 (VSS), U11.2 (GND), U13.4 (VSS), U14.4 (GND), Y1.2 (G), Y1.4 (G); also elsewhere on the board
unnamed: C96.1, U3.48 (VCAP)
unnamed: C97.1, U3.73 (VCAP)
unnamed: C105.1, H1.1, R83.1
unnamed: C106.1, H2.1, R84.1
unnamed: C107.1, H3.1, R85.1
unnamed: C108.1, H4.1, R86.1
unnamed: D2.2 (A), R6.2
unnamed: D4.2 (A), Q1.4 (G), R8.1
unnamed: D5.2 (A), R81.2
unnamed: D6.2 (A), R82.2
unnamed: D14.2 (A), R79.2
unnamed: D15.2 (A), R80.2
unnamed: J4.A5 (CC1), R1.1
unnamed: J4.B5 (CC2), R4.1
unnamed: Q2.2 (G), Q4.1 (D), R70.2
unnamed: Q3.2 (G), R11.1
unnamed: Q4.2 (G), R68.2, R69.1
unnamed: C3.2, U1.1 (DV_DT)
unnamed: R2.2, R3.1, U1.2 (EN_UVLO)
unnamed: R5.2, U1.7 (ILM)
unnamed: R62.1, U3.29 (PA5)
unnamed: R63.1, U3.31 (PA7)
unnamed: R64.2, U3.58 (PD11)
unnamed: R65.2, U3.59 (PD12)
unnamed: C100.1, U3.12 (PH0), Y1.1
unnamed: C64.1, U3.13 (PH1), Y1.3

Notes on the sheet:
need to run the stm32 AND the can transcever txrx from the same 3v3 hkpg
BOOT0 selects DFU at reset
picoblade
BOOT0 = LOW at reset → run your firmware (normal). BOOT0 = HIGH at reset → run ST's bootloader → chip shows up on the PC as a USB DFU device → we flash it.
CHANGE FP AWAY FROM SOD-123W
FPGA CONN
R5 select on test
remove for flight 1.27 mm pitch
USB-C
POWER
MCU DESIGN NOTES: - MCU osc caps: load cap ≈ 2 × (CL − C_stray) = 2 × (18 − ~4.5) ≈ 27pF
digital OR: if USB plugged in, ability to power MCU w just +5V_USB...
PL CONN
check 22R req for D+-
MCU
Chassis on flight
picolock
FPGA: - config: MCU as SPI master, FPGA in slave config mode - runtime:
MOUNTING HOLES
INPUT POWER
CAN
PLACEHOLDER W 10UF FOR DEV
MEMORY
SWD
POWER UP SEQ: HK rails immediately on Initialise H7 Enable PL rails Check PGOOD Begin PL operation

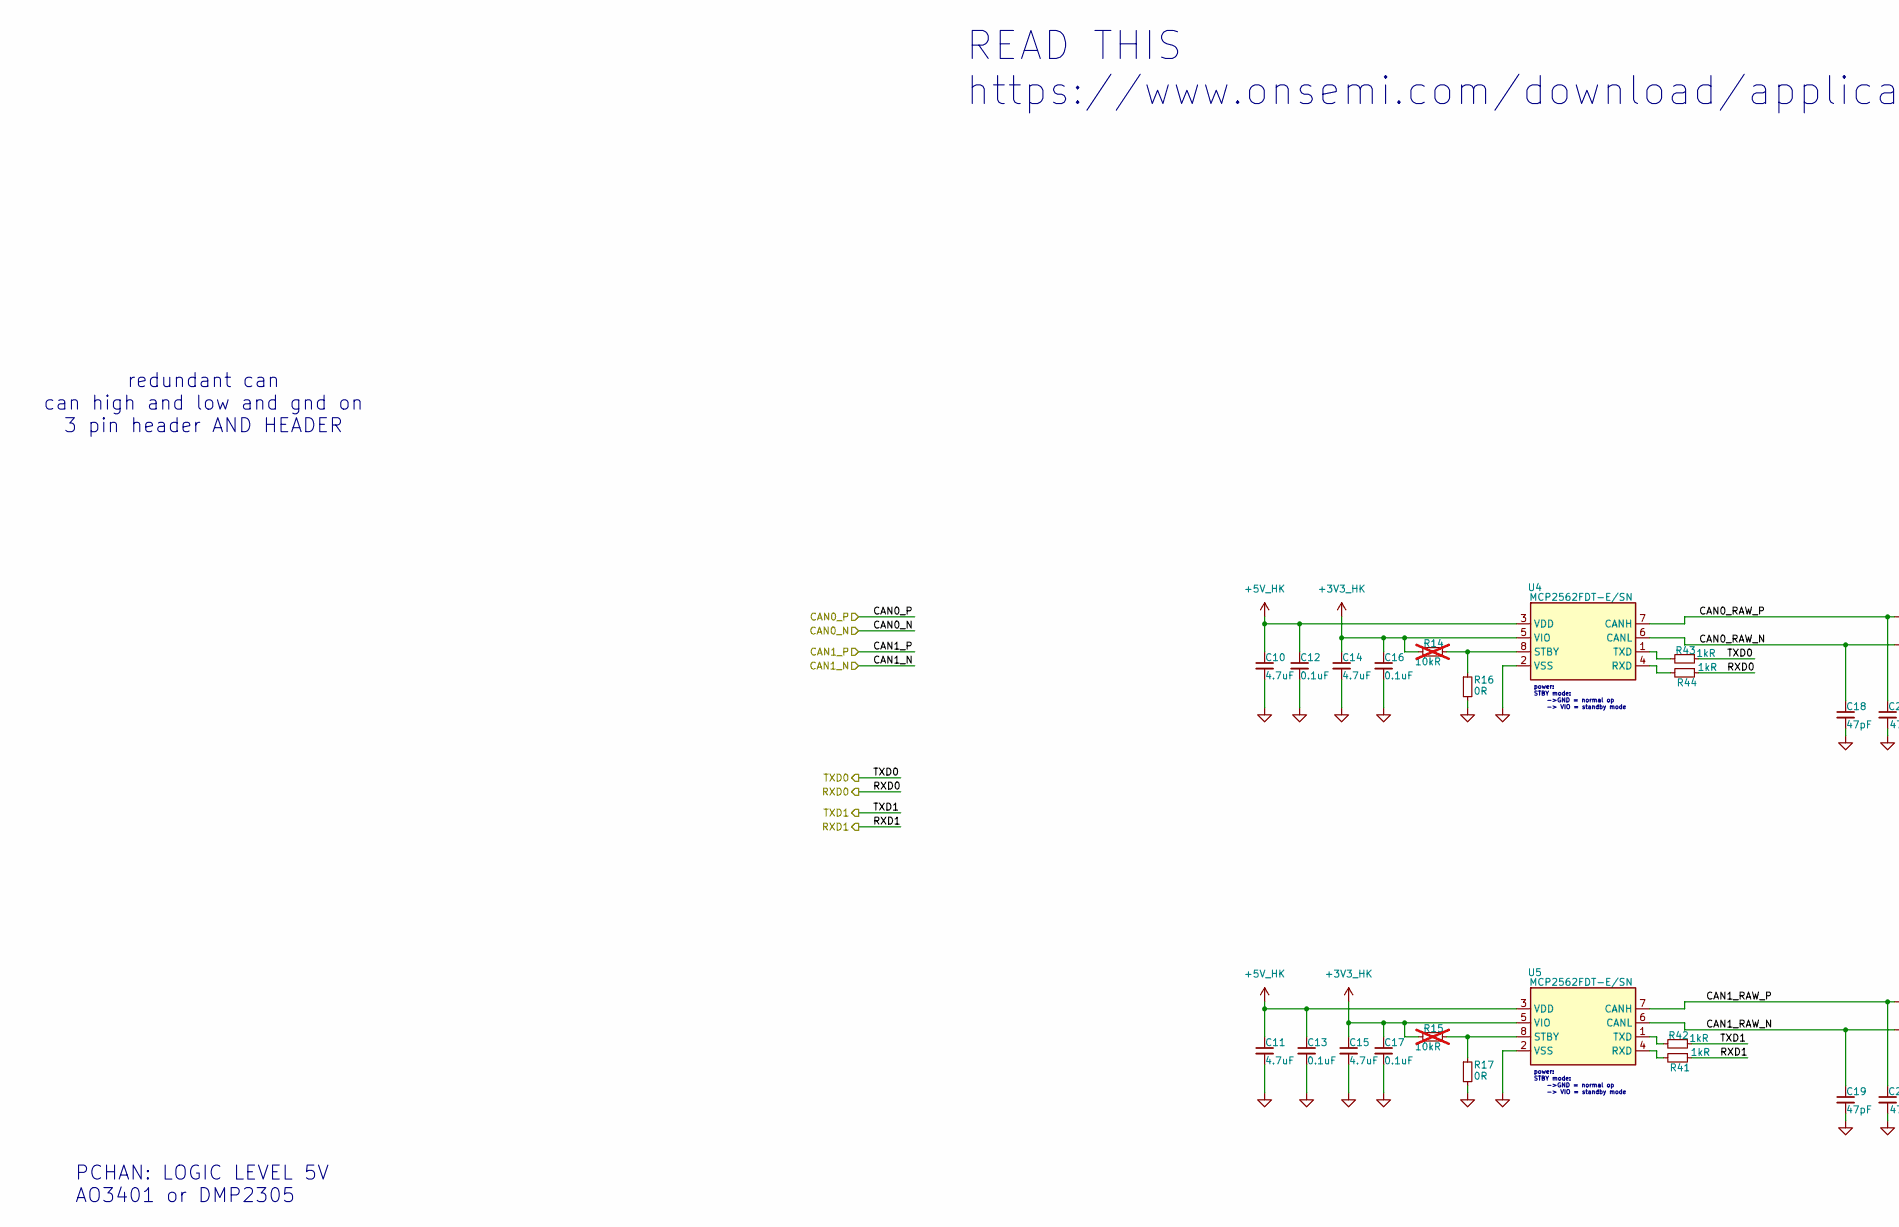
[picture p8: schematic CAN.kicad_sch, part in row 1, column 1]

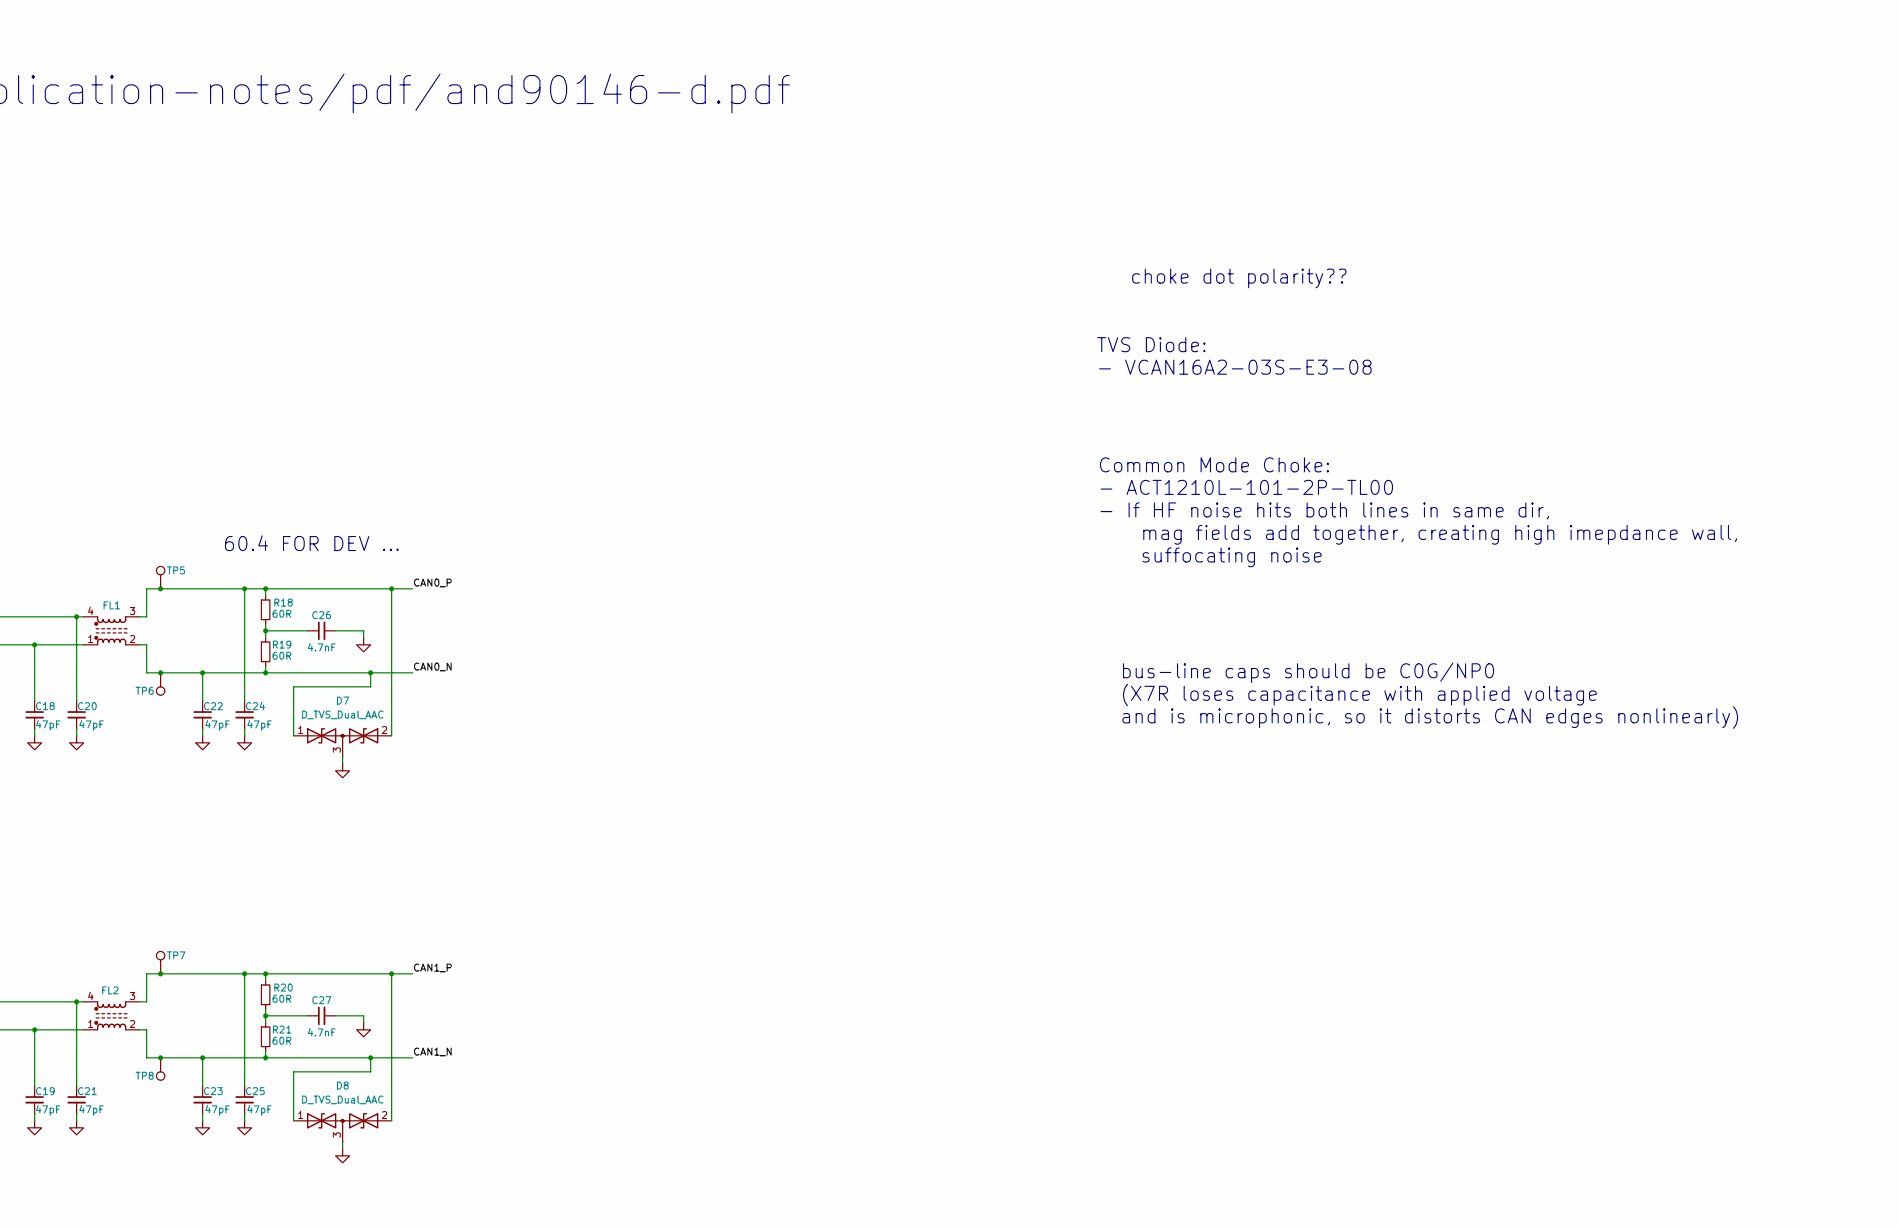
[picture p9: schematic CAN.kicad_sch, part in row 1, column 2]

Parts:
C10, C11, C14, C15: 4.7uF; C_0603_1608Metric; MPN MSAST168BB5475MTNA01
C12, C13, C16, C17: 0.1uF; C_0603_1608Metric; MPN GCM188R71H104KA57D
C18, C19, C20, C21, C22, C23, C24, C25: 47pF; C_0603_1608Metric; MPN GCM1885C1H470JA16D
C26, C27: 4.7nF; C_0603_1608Metric; MPN GCM1885C1H472GA16D
D7, D8: D_TVS_Dual_AAC; SOT-23-3; MPN ESD16VHYFHT116
FL1, FL2: Choke_CommonMode_FerriteCore_1243; L_CommonModeChoke_Coilcraft_1812CAN; MPN ACT45B-101-2P-TL003
R14, R15: 10kR; R_0603_1608Metric; MPN ERJ-3EKF1002V; not fitted
R16, R17: 0R; R_0603_1608Metric; MPN ERJ-3GEY0R00V
R18, R19, R20, R21: 60R; R_0603_1608Metric; MPN ERJ-3EKF60R4V
R41, R42, R43, R44: 1kR; R_0603_1608Metric; MPN ERJ-3EKF1001V
TP5, TP6, TP7, TP8: TestPoint; TestPoint_Pad_D1.0mm
U4, U5: MCP2562FDT-E/SN; SOIC-8_3.9x4.9mm_P1.27mm; MPN MCP2562FDT-E/SN

Connections:
+3V3_HK: C14.1, C15.1, C16.1, C17.1, R14.2, R15.2, U4.5 (VIO), U5.5 (VIO); also elsewhere on the board
+5V_HK: C10.1, C11.1, C12.1, C13.1, U4.3 (VDD), U5.3 (VDD); also elsewhere on the board
/CAN0_N: C22.1, D7.1 (A1), FL1.2, R19.2, TP6.1; also elsewhere on the board
/CAN0_P: C24.1, D7.2 (A2), FL1.3, R18.1, TP5.1; also elsewhere on the board
/CAN0_RX: R44.1; also elsewhere on the board
/CAN0_TX: R43.1; also elsewhere on the board
/CAN1_N: C23.1, D8.1 (A1), FL2.2, R21.2, TP8.1; also elsewhere on the board
/CAN1_P: C25.1, D8.2 (A2), FL2.3, R20.1, TP7.1; also elsewhere on the board
/CAN1_RX: R41.1; also elsewhere on the board
/CAN1_TX: R42.1; also elsewhere on the board
/CAN/CAN0_RAW_N: C18.1, FL1.1, U4.6 (CANL)
/CAN/CAN0_RAW_P: C20.1, FL1.4, U4.7 (CANH)
/CAN/CAN1_RAW_N: C19.1, FL2.1, U5.6 (CANL)
/CAN/CAN1_RAW_P: C21.1, FL2.4, U5.7 (CANH)
GND: C10.2, C11.2, C12.2, C13.2, C14.2, C15.2, C16.2, C17.2, C18.2, C19.2, C20.2, C21.2, C22.2, C23.2, C24.2, C25.2, C26.2, C27.2, D7.3 (common), D8.3 (common), R16.2, R17.2, U4.2 (VSS), U5.2 (VSS); also elsewhere on the board
unnamed: C26.1, R18.2, R19.1
unnamed: C27.1, R20.2, R21.1
unnamed: R44.2, U4.4 (RXD)
unnamed: R14.1, R16.1, U4.8 (STBY)
unnamed: R43.2, U4.1 (TXD)
unnamed: R41.2, U5.4 (RXD)
unnamed: R15.1, R17.1, U5.8 (STBY)
unnamed: R42.2, U5.1 (TXD)

Notes on the sheet:
choke dot polarity??
bus-line caps should be C0G/NP0 (X7R loses capacitance with applied voltage and is microphonic, so it distorts CAN edges nonlinearly)
TVS Diode: - VCAN16A2-03S-E3-08
Common Mode Choke: - ACT1210L-101-2P-TL00 - If HF noise hits both lines in same dir, mag fields add together, creating high imepdance wall, suffocating noise
power: STBY mode: ->GND = normal op -> VIO = standby mode
PCHAN: LOGIC LEVEL 5V AO3401 or DMP2305
60.4 FOR DEV ...
redundant can can high and low and gnd on 3 pin header AND HEADER
READ THIS https://www.onsemi.com/download/application-notes/pdf/and90146-d.pdf
