kpayinda/PIM_V01/(commit log)

2026-08-12 V01 RELEASE. Gerbers created to order RAW PCB
    [PIM_V01-BOT.gbl, PIM_V01-B_Mask.gbs, PIM_V01-B_Paste.gbp, PIM_V01-B_Silkscreen.gbo, PIM_V01-Edge_Cuts.gm1, PIM_V01-F_Mask.gts, PIM_V01-F_Paste.gtp, PIM_V01-F_Silkscreen.gto]
2026-09-03 updated some of the 3D bodies, and updated the BRINGUP plan with results from the first attempt at population; many components were not made in the order, so am now blocked waiting for those.
    [CAN.kicad_sch, PIM_V01.kicad_pcb, PIM_V01.kicad_sch, PIM_V01_BOM.csv, POWER.kicad_sch]
2026-09-08 finished uploading all of the correct footprints and 3D bodies. this is now done, and barely different than what was fabricated - used all manufacturers FPs (instead of kicads), but this didn't cause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
    [CAN.kicad_sch, PIM_V01.kicad_pcb, PIM_V01.kicad_sch, POWER.kicad_sch]
2026-09-19 somehow last push my components had lost their values, and only displayed their Kicad value, but I fixed that now
    [CAN.kicad_sch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]
2026-09-21 updated the last few component symbols/fps, none very significant
    [PIM_V01.kicad_pcb, PIM_V01.kicad_sch, POWER.kicad_sch]
